robokoding/sumorobot-pcb/README.md

# sumorobot-pcb

The KiCad files for the sumorobot PCB

Schematics
Board
Board

support
=======
If you find our work useful, please consider donating : )  
Donate using Liberapay (https://liberapay.com/robokoding/donate)  

credits
=======
* KiCad
* ESP32 community
