robokoding/sumorobot-pcb/(threads)

Thread 3 (2018-03-26):

0R1 resistor footprint

silps, 2018-03-26:
the leg holes are too narrow
