robokoding/sumorobot-pcb/(commit log)

2017-10-12 sumoboard v0.2
    [sumoboard.kicad_pcb, sumoboard.sch]
2018-11-04 update to v0.3.1
    [sumoboard.kicad_pcb, sumoboard.sch]
2019-01-10 add new line sensor, move ultrasonic, update connections
    [sumoboard.kicad_pcb, sumoboard.sch]
2019-01-11 improved breakaway tabs
    [sumoboard.kicad_pcb]
2019-09-05 update to v0.4.2
    [sumoboard.kicad_pcb, sumoboard.sch]
2019-09-05 update rgb LED footprint
    [sumoboard.kicad_pcb]
