robokoding/sumorobot-pcb/(notices)

Notices in the files:
sumoboard.kicad_pcb:
MIT license
